Elipam/Smart-Things---Home-station-server/README.md

# Smart-Things---Home-station-server
Centrale applicatie van het home station project.
