Elipam/Smart-Things---Home-station-server/opleverSetHomestation/behuizing.stl.stl

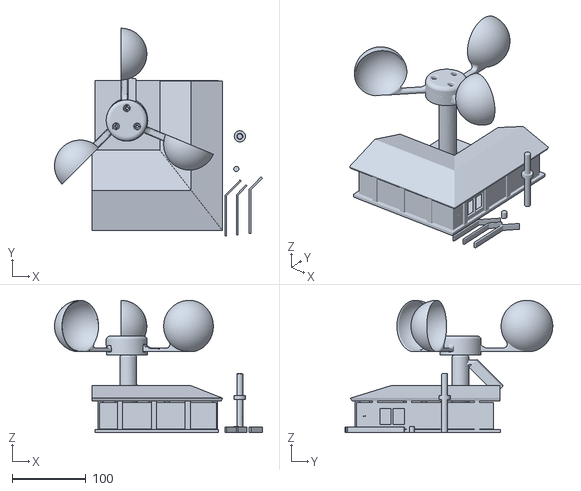
[picture p8: CAD file, 2024-11-17]
opleverSetHomestation/behuizing.stl.stl
281.6 x 281.0 x 179.1
