Elipam/Smart-Things---Home-station-server/opleverSetHomestation/Kalibratie tabel.xlsx

 | annemometer meting m/s | eigen windmeter aantal pulsen in 10 seconden | Ldr Homaestation | Luxmeter | tempSensor Homestation | thermometer | humMeter homestation | humMeter stadslab
meting 1 | 1,8 | 5 | 840 | 2000 | 22.4 | 22 | 46 | 45
meting 2 | 1,5 | 5 | 540 | 440 | 18.6 | 19 | 96 | 93 | y = 3.7129x - 3.0873
meting 3 | 1,8 | 10 | 230 | 60 |  |  |  |  | (y + 3.0873) / 3.7129 = x
meting 4 | 1,7 | 10 | 70 | 0
meting 5 | 2,1 | 14
meting 6 | 2,1 | 14
meting 7 | 2,0 | 14
meting 8 | 2,0 | 11
meting 9 | 3,0 | 29
meting 10 | 3,2 | 34
meting 11 | 3,1 | 37
meting 12 | 3,2 | 39
meting 13 | 4,4 | 56
meting 14 | 4,5 | 55
meting 15 | 4,5 | 53
meting 16 | 4,6 | 60
meting 17 | 5,3 | 76 |  |  |  |  |  |  | y = 2.5226x - 434.5
meting 18 | 5,2 | 65 |  |  |  |  |  |  | (y + 434.5) / 2.5226 = x
meting 19 | 5,2 | 68
meting 20 | 5,5 | 69
meting 21 | 6,1 | 85
meting 22 | 5,8 | 90
meting 23 | 6,2 | 80
meting 24 | 6,1 | 87
meting 25 | 6,7 | 91
meting 26 | 6,9 | 87
meting 27 | 6,8 | 86
meting 28 | 6,7 | 91
meting 29 | 7,0 | 94
meting 30 | 7,2 | 89
meting 31 | 7,3 | 89
meting 32 | 7,3 | 82
meting 33
meting 34
meting 35
meting 36
meting 37
meting 38
meting 39
